CollinObrien1/Custom-Buck-Converter/README.md

This is a repository for our Buck Converter Preliminary Design for ELEC 4450: Power Electronics.

The most up-to-date version of the PCB as of 2025-03-02 is: Buck_PCB- R3.0

EDA Models can be found in the folder: EDA Models

Thank you,

Gavin F., Collin O., Sahana J.
