CollinObrien1/Custom-Buck-Converter/EDA Models/1140-123K-RC/1140-123k-rc.stp

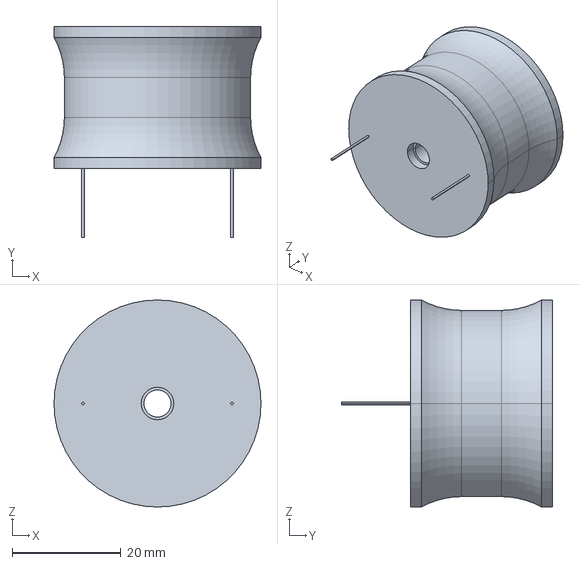
[picture p1: CAD file, 2025-02-24]
EDA Models/1140-123K-RC/1140-123k-rc.stp
38.1 x 38.9 x 38.1 mm
