CollinObrien1/Custom-Buck-Converter/EDA Models/61202021621/6120XX21621_61202021621.step

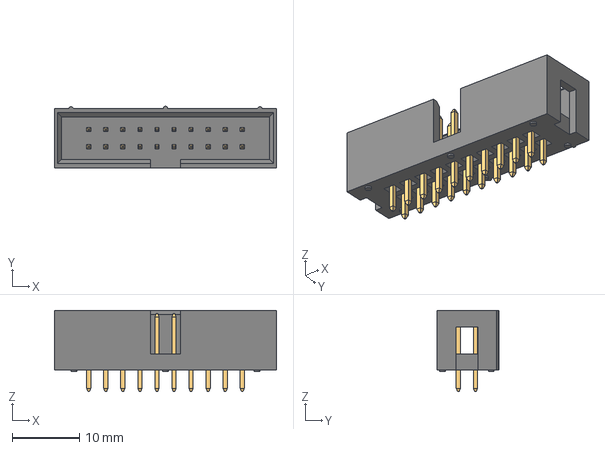
[picture p2: CAD file, 2025-03-02]
EDA Models/61202021621/6120XX21621_61202021621.step
33.1 x 9.18 x 12.1 mm
6120xx21621_PIN x 20
