CollinObrien1/Custom-Buck-Converter/EDA Models/Banana/BU-P72930-2.stp

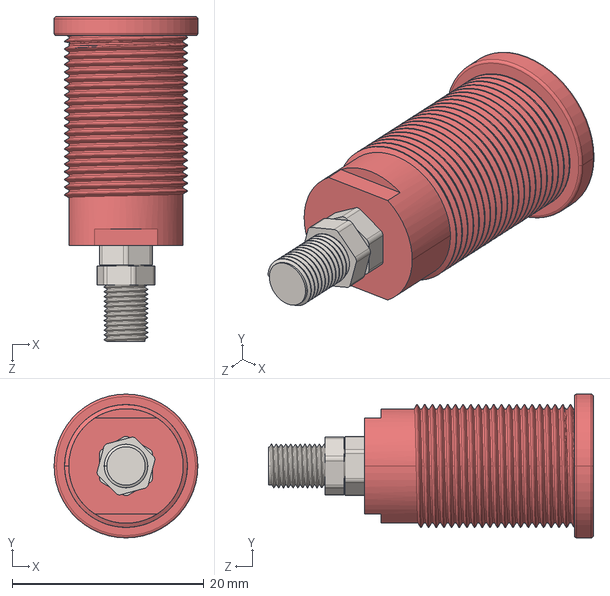
[picture p3: CAD file, 2025-02-24]
EDA Models/Banana/BU-P72930-2.stp
15.0 x 15.0 x 33.9 mm
