CollinObrien1/Custom-Buck-Converter/EDA Models/LM358AP/LM358AP.step

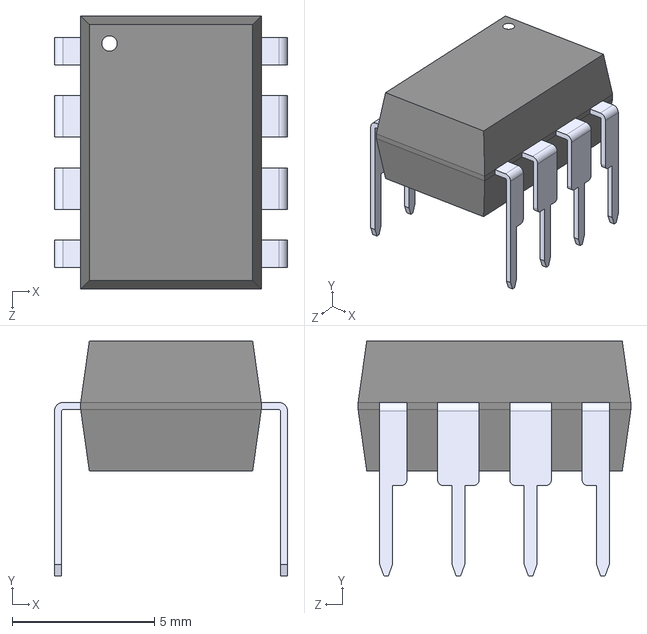
[picture p4: CAD file, 2025-03-02]
EDA Models/LM358AP/LM358AP.step
8.19 x 8.26 x 9.59 mm
