CollinObrien1/Custom-Buck-Converter/EDA Models/TMV_0512SHI/TMV-HI_SINGLE_TRP.step

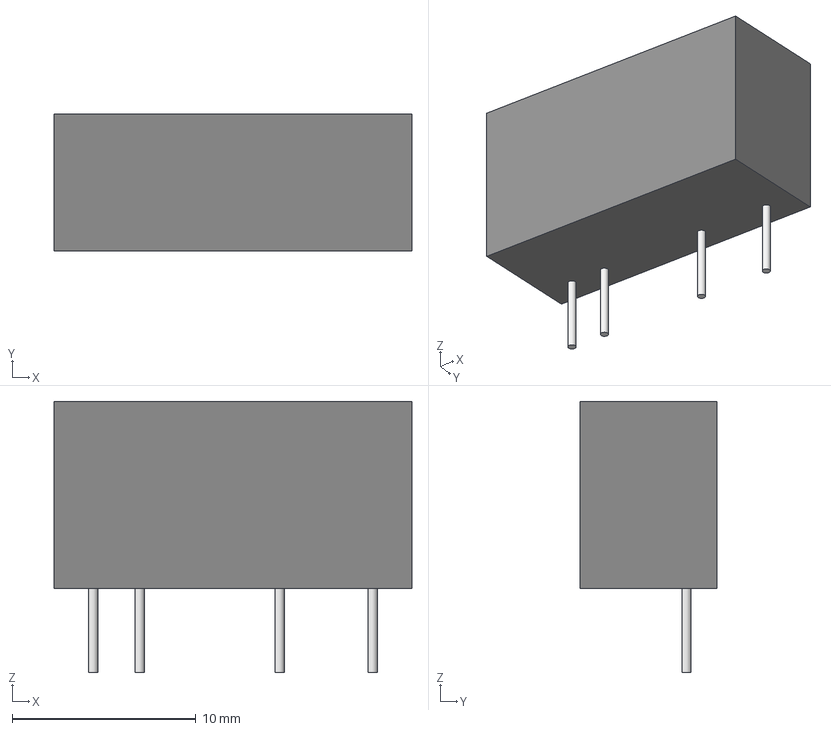
[picture p5: CAD file, 2025-02-24]
EDA Models/TMV_0512SHI/TMV-HI_SINGLE_TRP.step
19.5 x 7.49 x 14.8 mm
