CollinObrien1/Custom-Buck-Converter/EDA Models/TSW-110-07-F-D/TSW-110-07-F-D.step

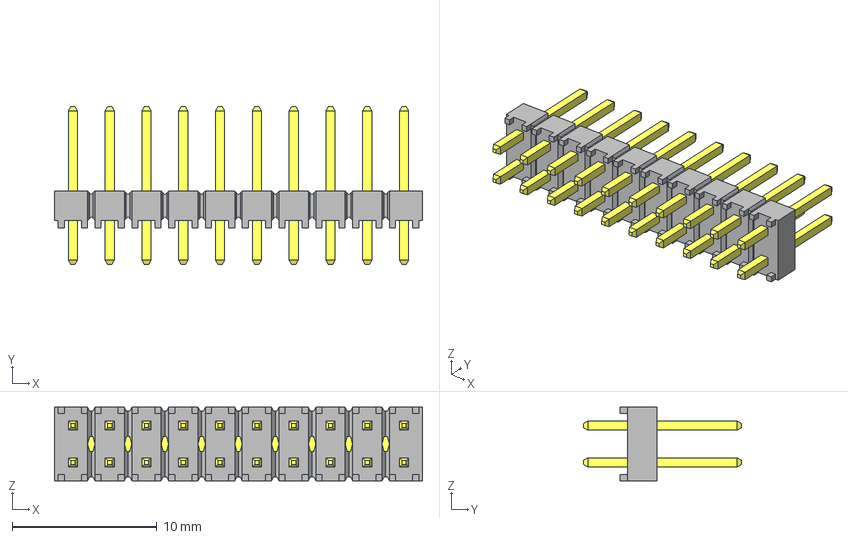
[picture p6: CAD file, 2025-02-24]
EDA Models/TSW-110-07-F-D/TSW-110-07-F-D.step
25.4 x 10.9 x 5.08 mm
TSW-110-07-F-D_body
T-1S6-07-TSW-1-07-10-D
