CollinObrien1/Custom-Buck-Converter/EDA Models/UCC5304DWVR/DWV0008A.stp

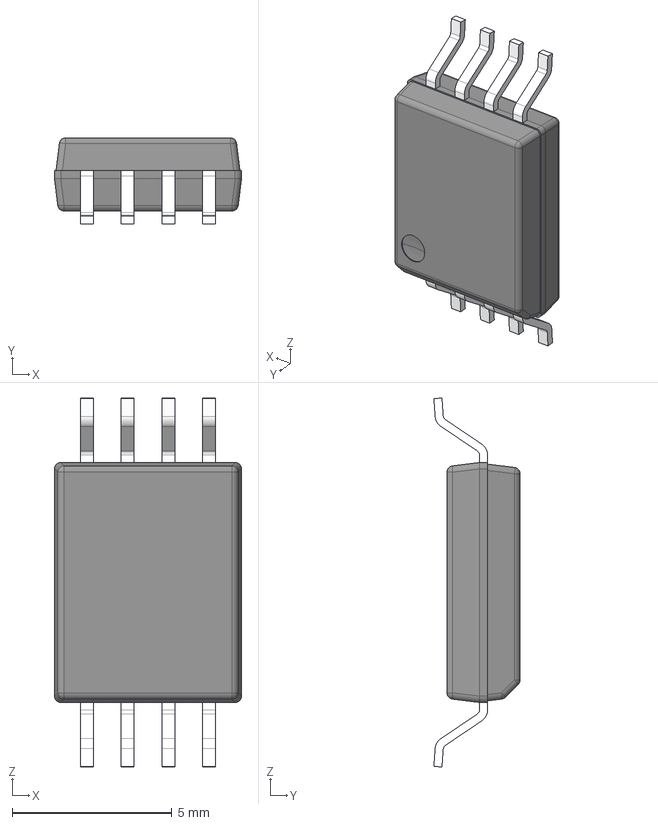
[picture p7: CAD file, 2025-02-24]
EDA Models/UCC5304DWVR/DWV0008A.stp
5.85 x 2.70 x 11.5 mm
BODY-SOIC
LEAD-DWV0008A x 8
