CollinObrien1/Custom-Buck-Converter/EDA Models/507302B00000G/507302B00000G.step

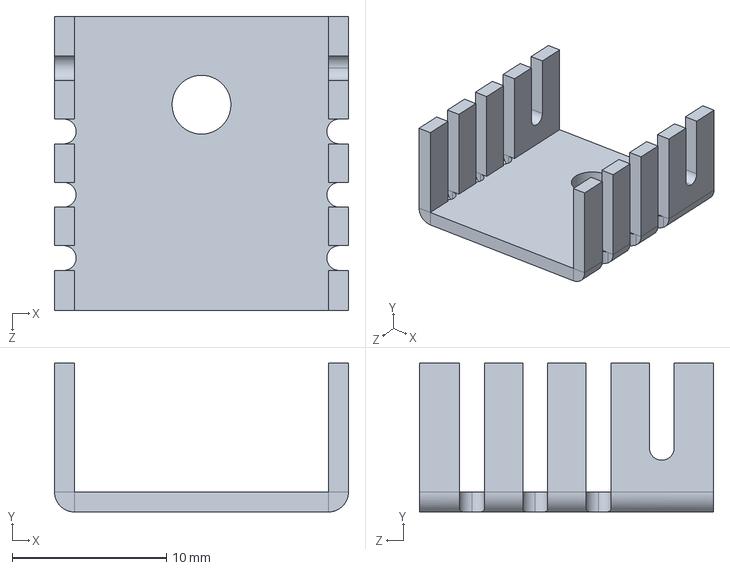
[picture p8: CAD file, 2025-02-24]
EDA Models/507302B00000G/507302B00000G.step
19.1 x 9.65 x 19.1 mm
