CollinObrien1/Custom-Buck-Converter/EDA Models/971100154/971100154.stp

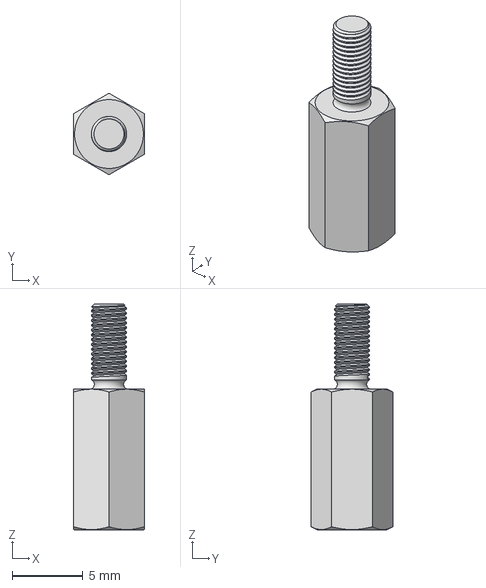
[picture p9: CAD file, 2025-03-02]
EDA Models/971100154/971100154.stp
5.00 x 5.77 x 16.0 mm
