CollinObrien1/Custom-Buck-Converter/(notices)

Notices in the files:
EDA Models/TSW-110-07-F-D/TSW-110-07-F-D.step:
author */ ('License CC BY-ND 4.0'),
